jacksondean17/TouchFaderBank/Documentation/LED Test Layout.pdf

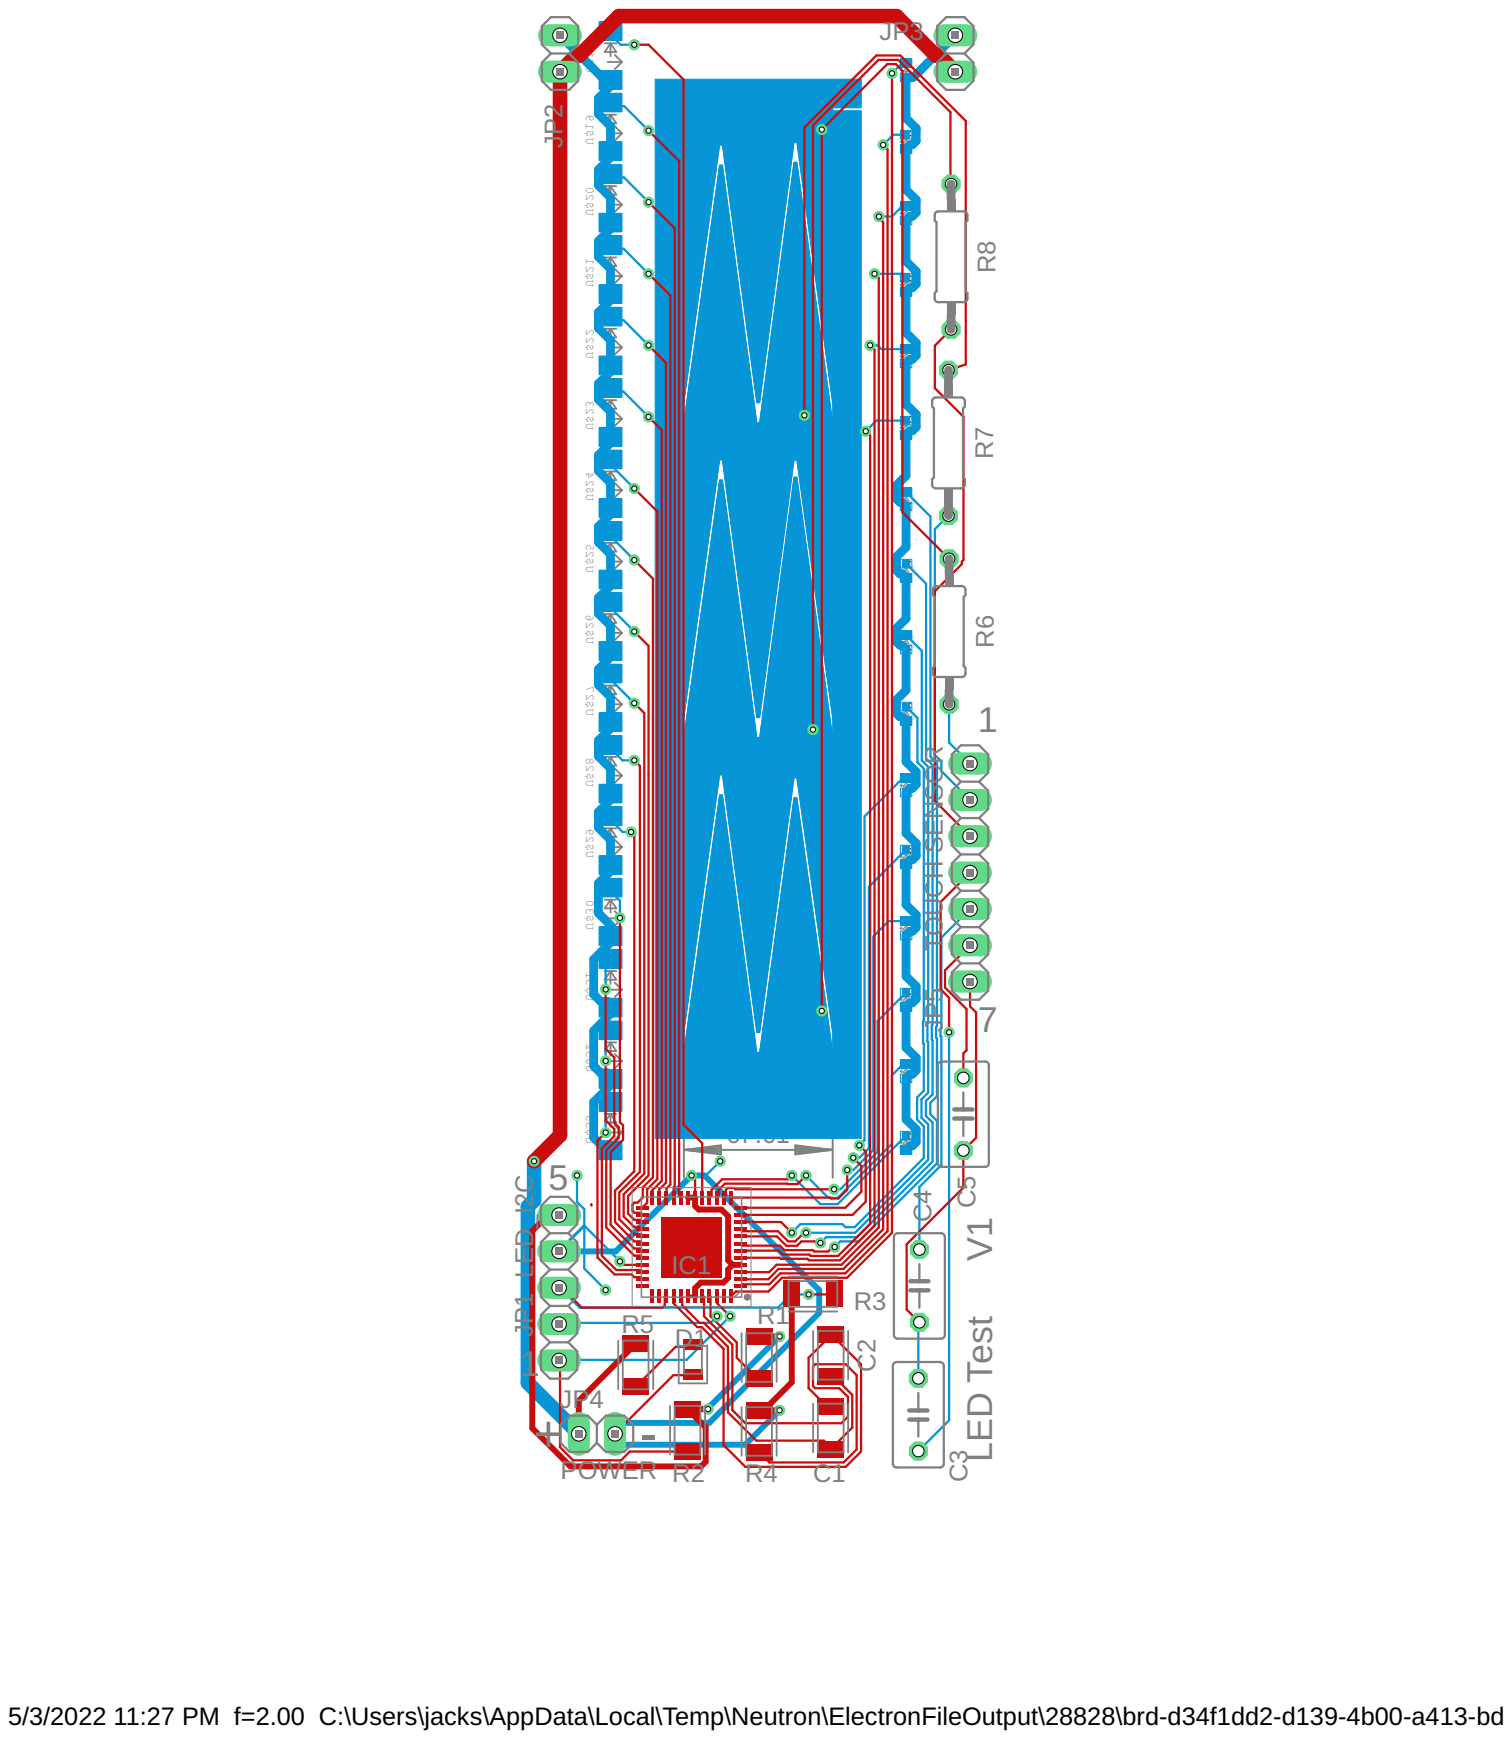
[picture p1: page 1]

5/3/2022 11:27 PM f=2.00 C:\Users\jacks\AppData\Local\Temp\Neutron\ElectronFileOutput\28828\brd-d34f1dd2-d139-4b00-a413-bda9a6092a5e\LED Test v11.brd
