jacksondean17/TouchFaderBank/Documentation/LED Test Schematic.pdf

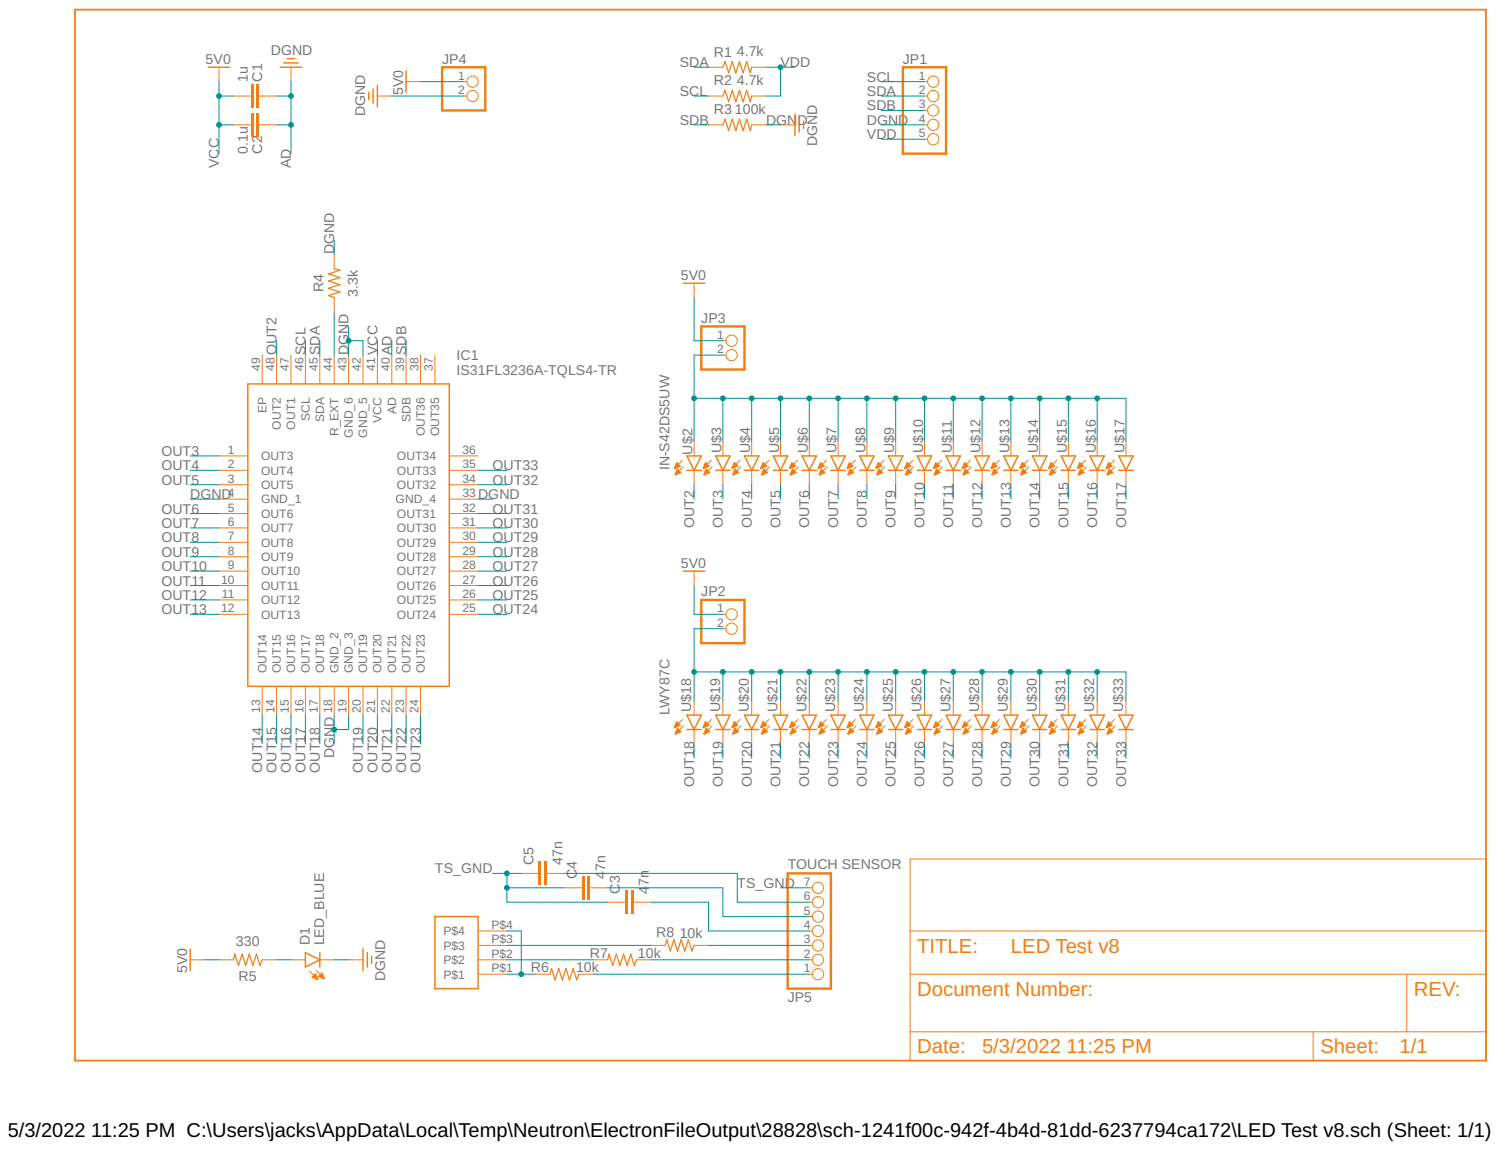
[picture p2: page 1]

Document Number: | REV:

Date: 5/3/2022 11:25 PM | Sheet: 1/1

5/3/2022 11:25 PM C:\Users\jacks\AppData\Local\Temp\Neutron\ElectronFileOutput\28828\sch-1241f00c-942f-4b4d-81dd-6237794ca172\LED Test v8.sch (Sheet: 1/1)
