jacksondean17/TouchFaderBank/Documentation/TouchFaderBank Schematic.pdf

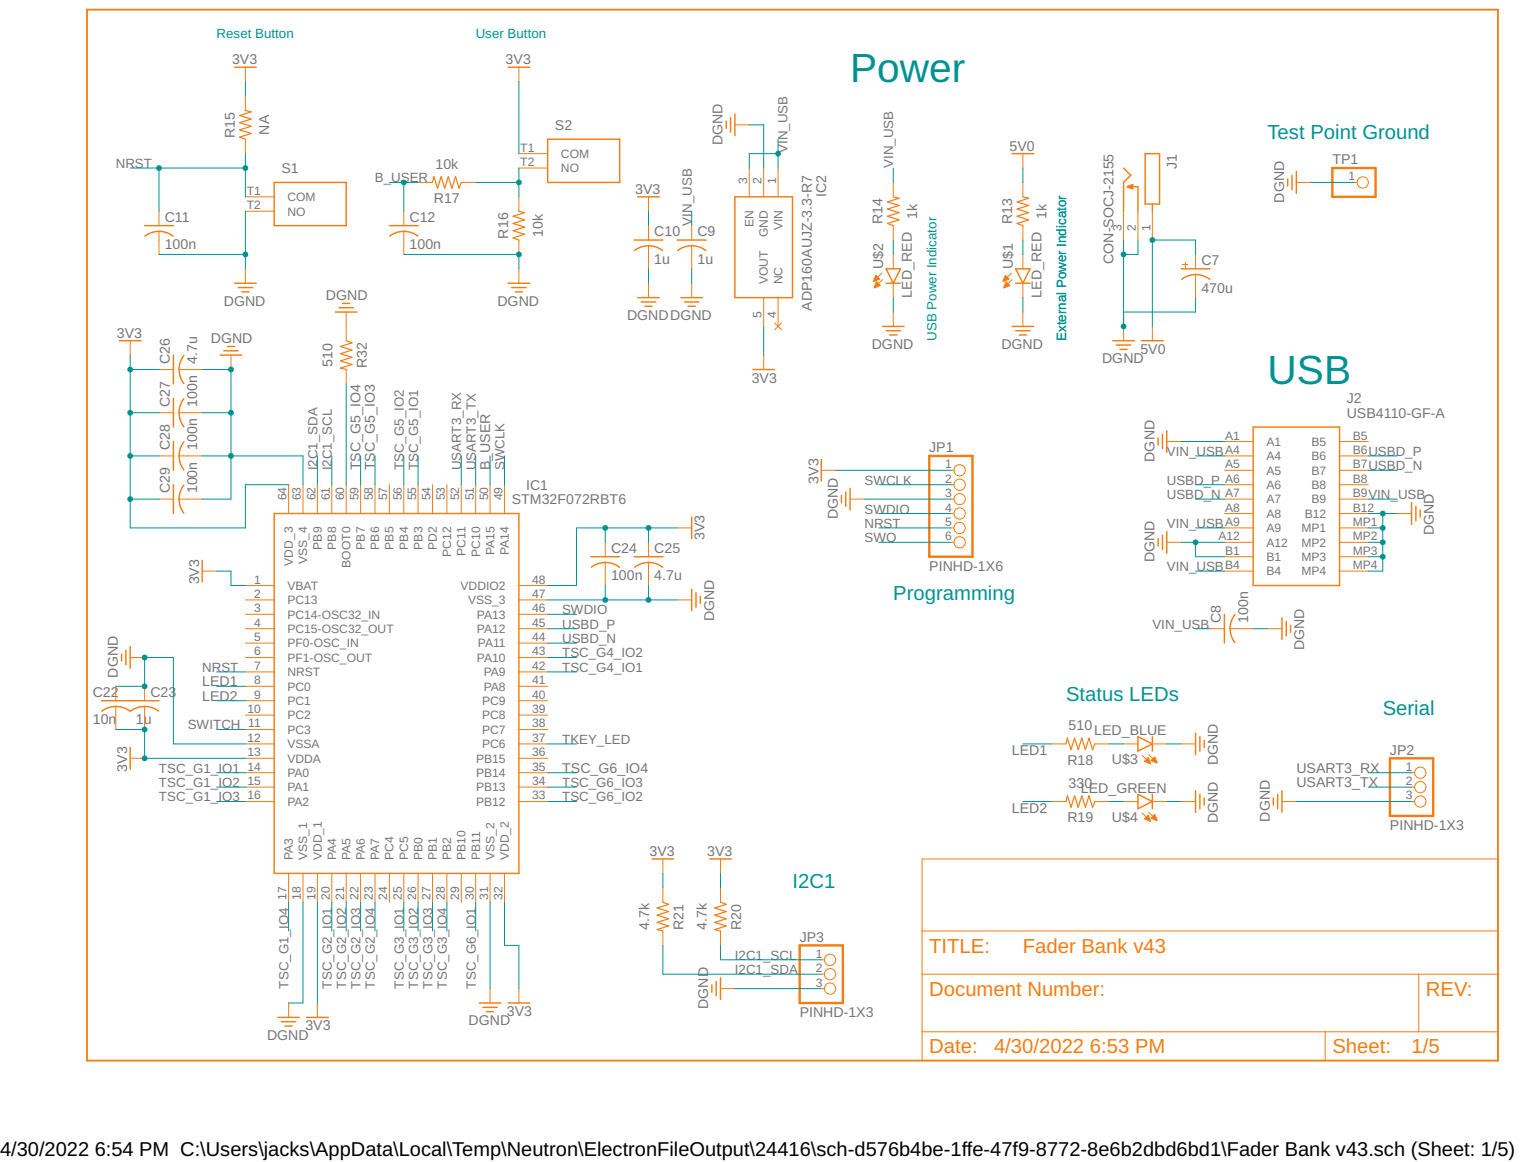
[picture p3: page 1]

External Power Indicator

Document Number: | REV:

Date: 4/30/2022 6:53 PM | Sheet: 1/5

4/30/2022 6:54 PM C:\Users\jacks\AppData\Local\Temp\Neutron\ElectronFileOutput\24416\sch-d576b4be-1ffe-47f9-8772-8e6b2dbd6bd1\Fader Bank v43.sch (Sheet: 1/5)

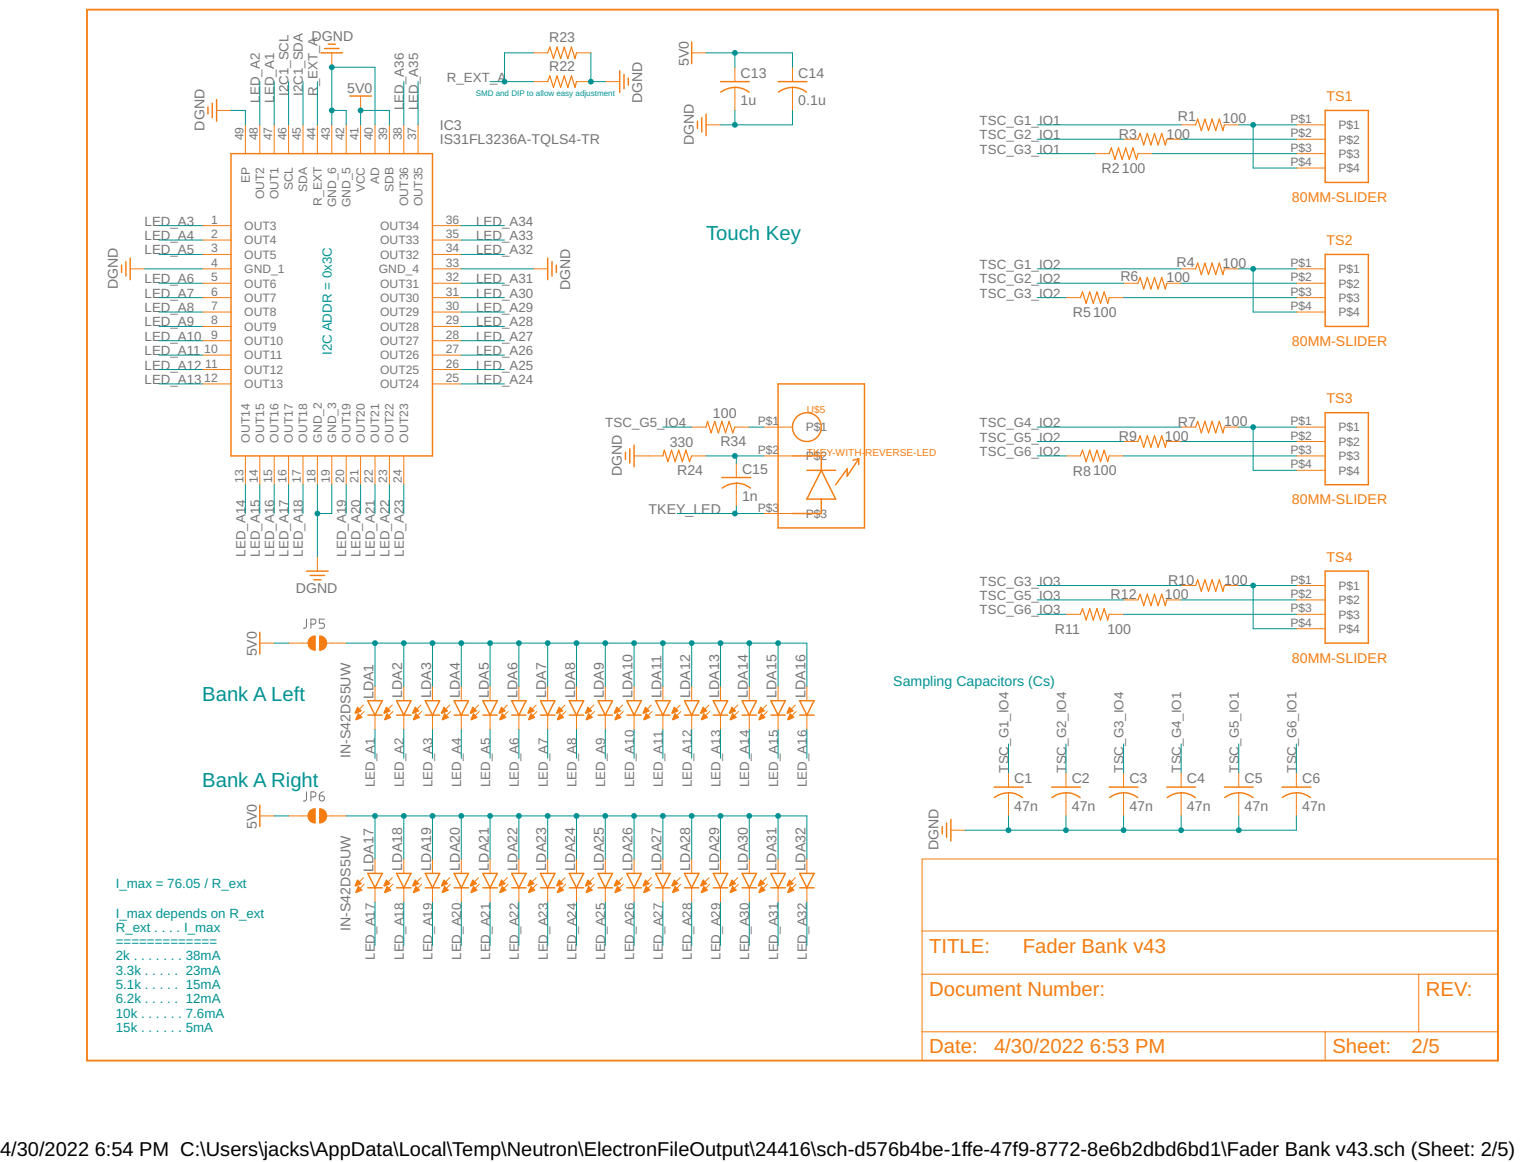
[picture p4: page 2]

SMD and DIP to allow easy adjustment

U$5 TKEY-WITH-REVERSE-LED

Document Number: | REV:

Date: 4/30/2022 6:53 PM | Sheet: 2/5

4/30/2022 6:54 PM C:\Users\jacks\AppData\Local\Temp\Neutron\ElectronFileOutput\24416\sch-d576b4be-1ffe-47f9-8772-8e6b2dbd6bd1\Fader Bank v43.sch (Sheet: 2/5)

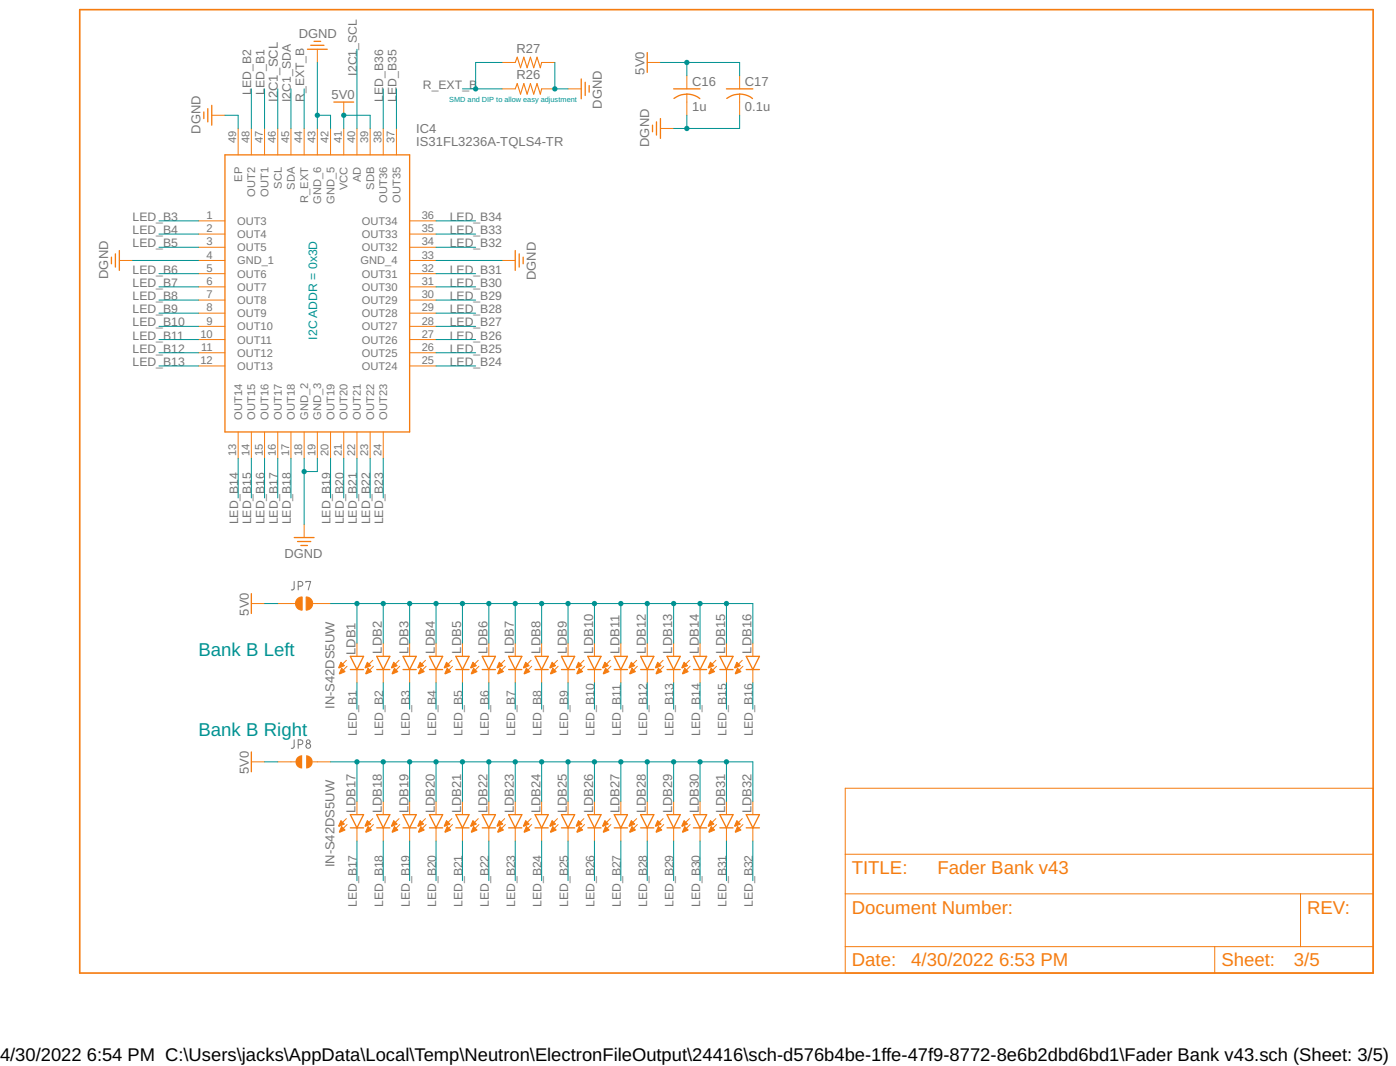
[picture p5: page 3]

SMD and DIP to allow easy adjustment

Document Number: | REV:

Date: 4/30/2022 6:53 PM | Sheet: 3/5

4/30/2022 6:54 PM C:\Users\jacks\AppData\Local\Temp\Neutron\ElectronFileOutput\24416\sch-d576b4be-1ffe-47f9-8772-8e6b2dbd6bd1\Fader Bank v43.sch (Sheet: 3/5)

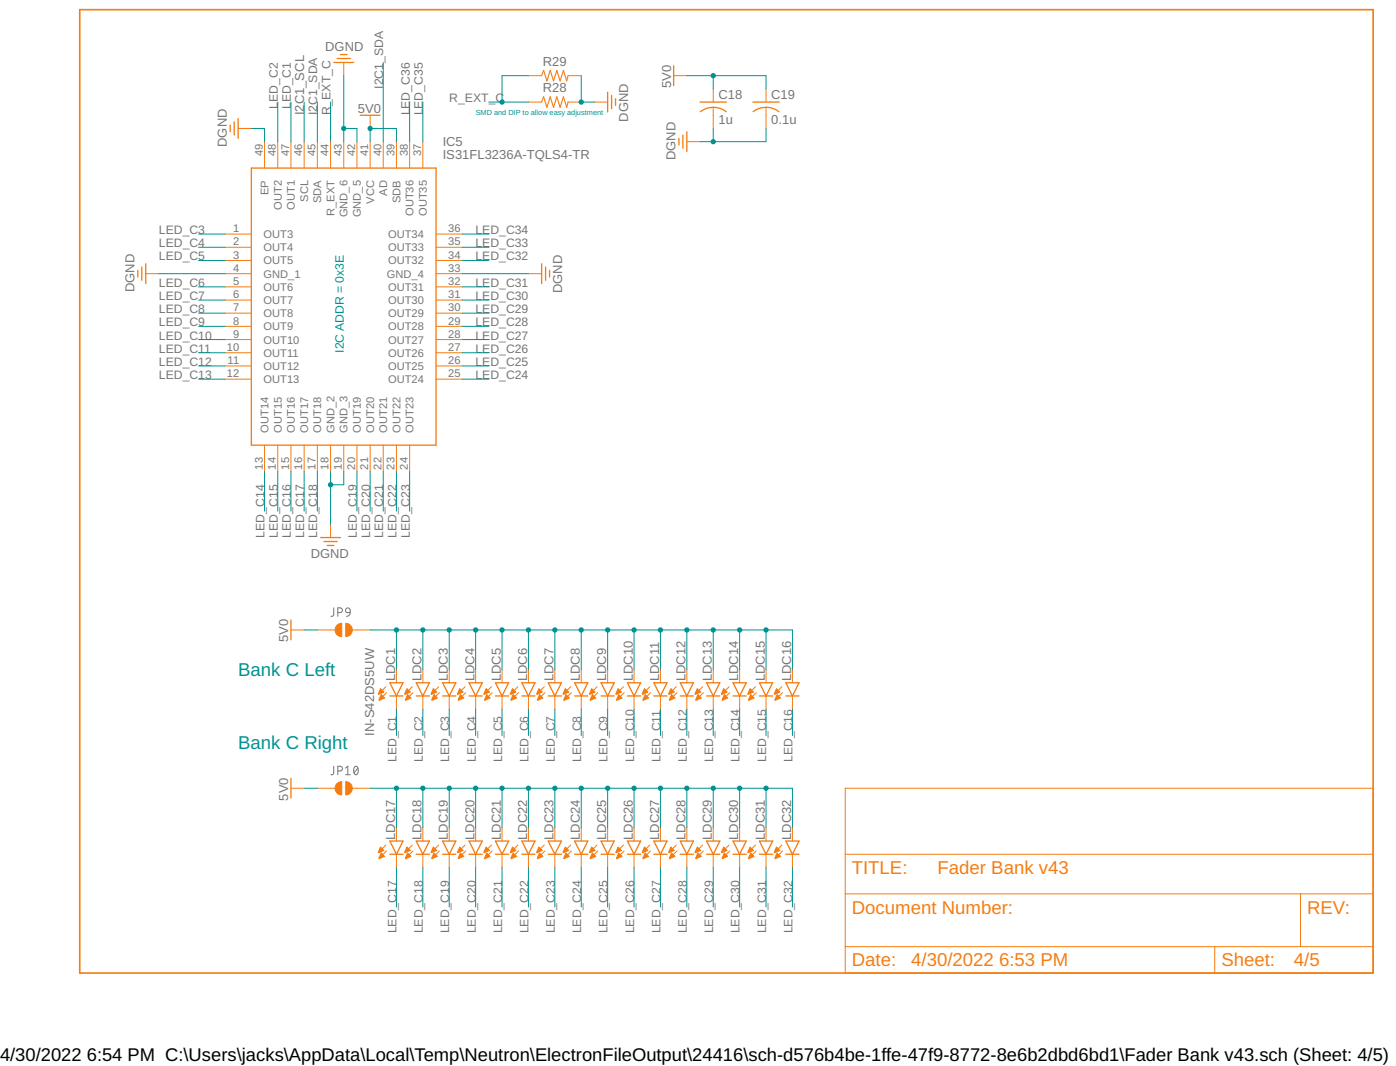
[picture p6: page 4]

SMD and DIP to allow easy adjustment

Document Number: | REV:

Date: 4/30/2022 6:53 PM | Sheet: 4/5

4/30/2022 6:54 PM C:\Users\jacks\AppData\Local\Temp\Neutron\ElectronFileOutput\24416\sch-d576b4be-1ffe-47f9-8772-8e6b2dbd6bd1\Fader Bank v43.sch (Sheet: 4/5)

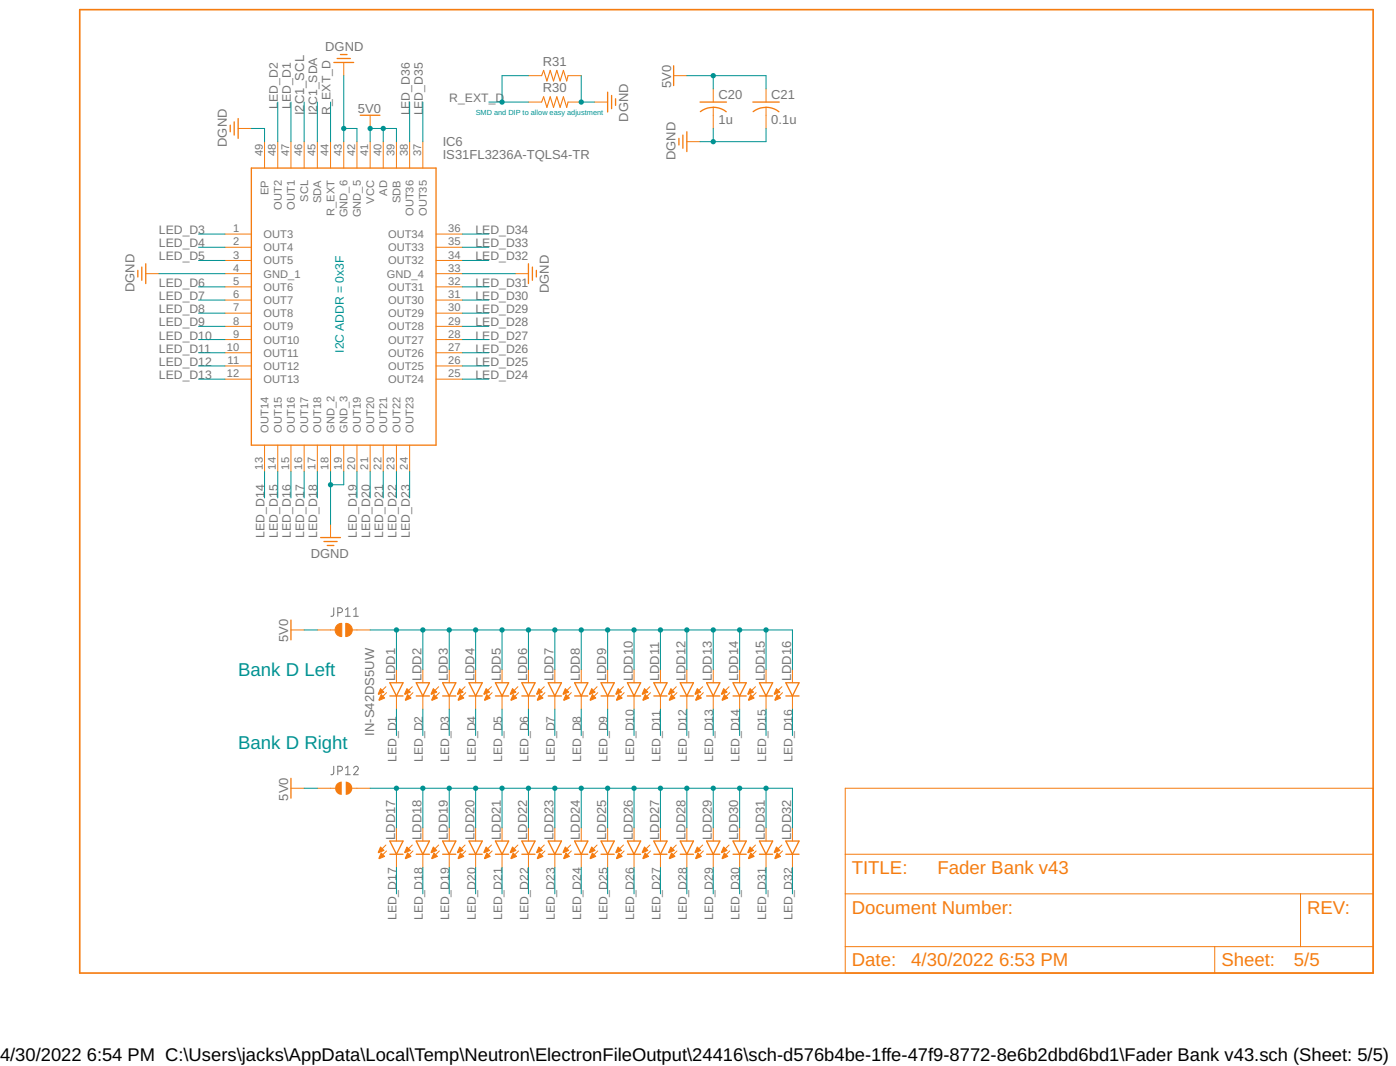
[picture p7: page 5]

SMD and DIP to allow easy adjustment

Document Number: | REV:

Date: 4/30/2022 6:53 PM | Sheet: 5/5

4/30/2022 6:54 PM C:\Users\jacks\AppData\Local\Temp\Neutron\ElectronFileOutput\24416\sch-d576b4be-1ffe-47f9-8772-8e6b2dbd6bd1\Fader Bank v43.sch (Sheet: 5/5)
