jacksondean17/TouchFaderBank/Documentation/TouchFaderBank Layout.pdf

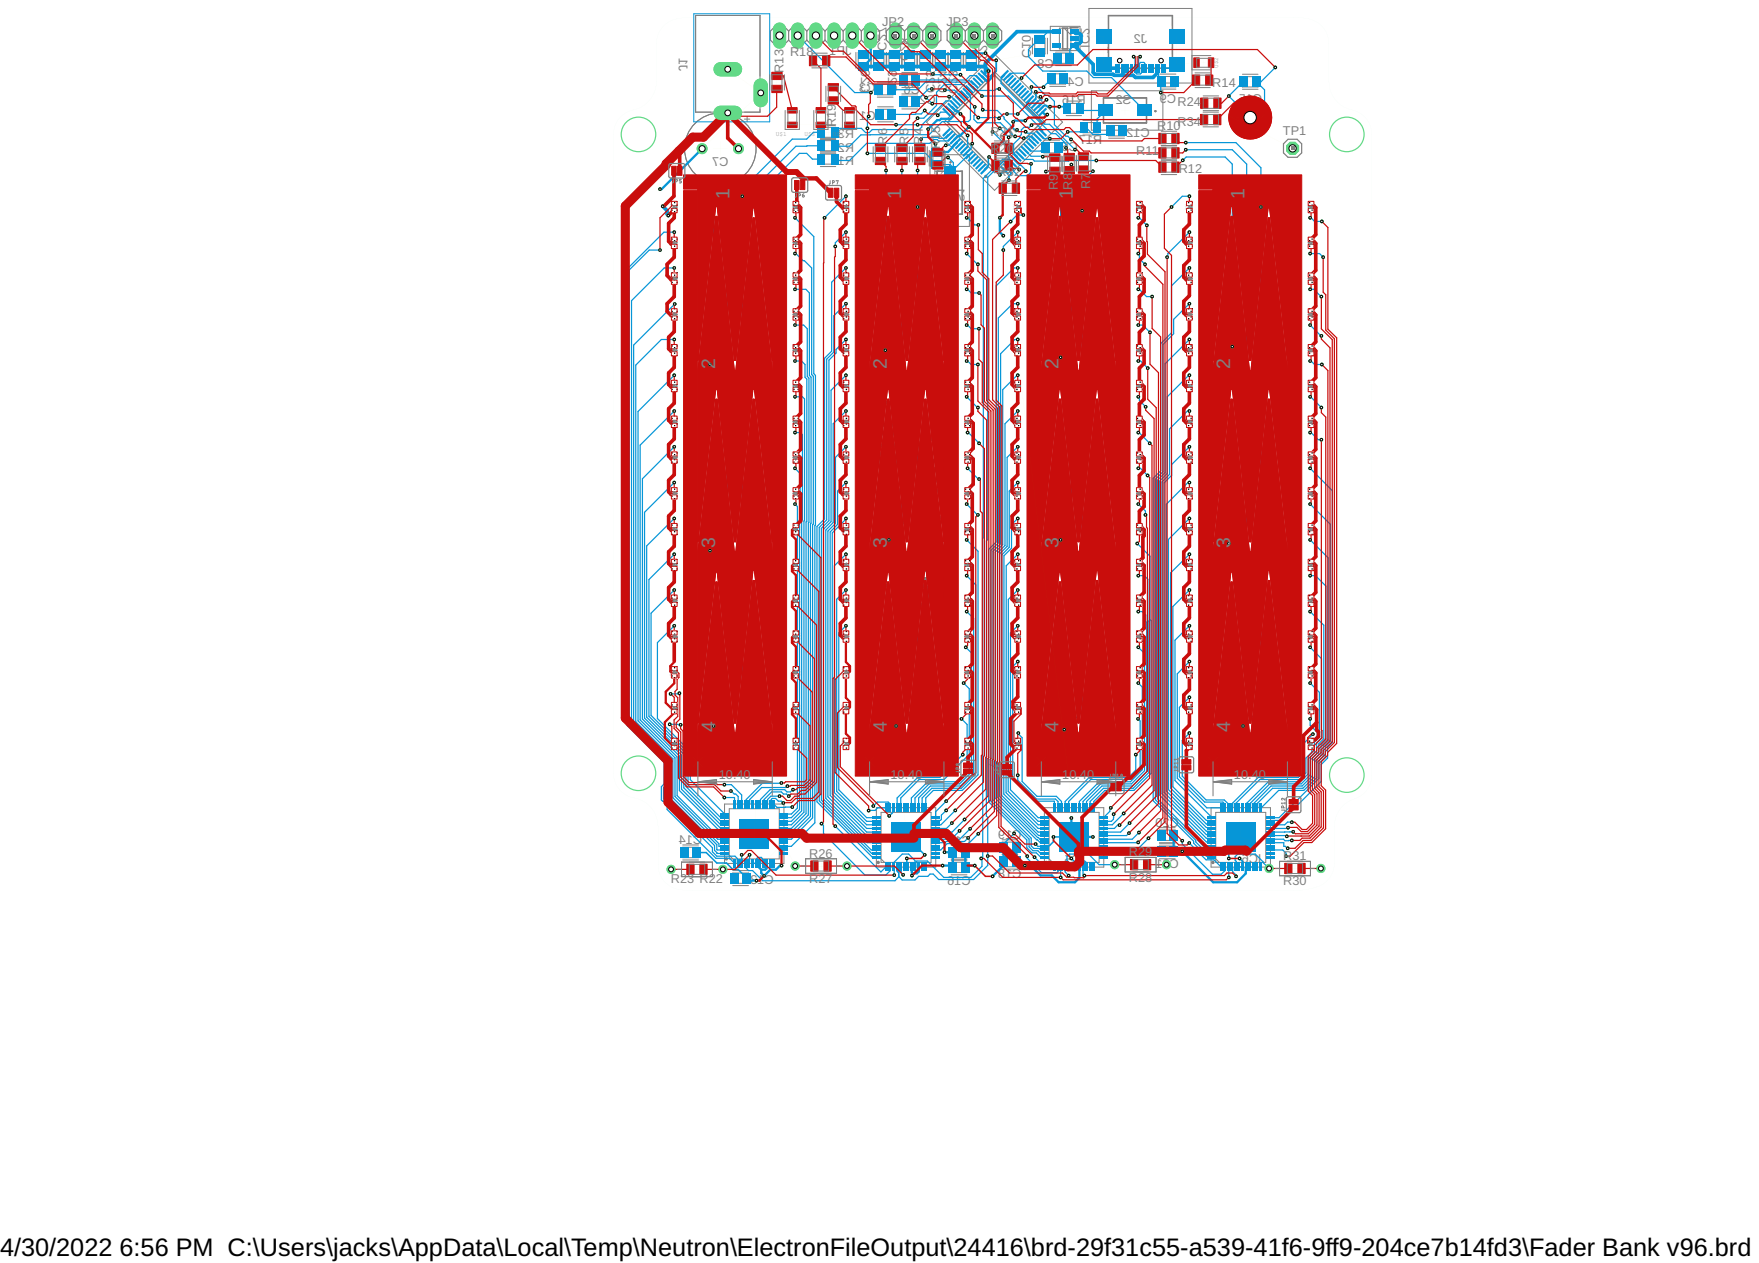
[picture p8: page 1]

4/30/2022 6:56 PM C:\Users\jacks\AppData\Local\Temp\Neutron\ElectronFileOutput\24416\brd-29f31c55-a539-41f6-9ff9-204ce7b14fd3\Fader Bank v96.brd
