jacksondean17/TouchFaderBank/Verification/SliderAndButtons/Core/Src/main.c

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
/* Includes ------------------------------------------------------------------*/
#include "main.h"
#include "touchsensing.h"

/* USER CODE BEGIN Includes */
#include <stdio.h>
/* USER CODE END Includes */

/* USER CODE BEGIN PD */
#define SBUF_SIZE (128)
/* USER CODE END PD */

/* USER CODE BEGIN PM */
#define LINEAR_DETECT(chan) ((MyLinRots[chan].p_Data->StateId == TSL_STATEID_DETECT) || \
                       (MyLinRots[chan].p_Data->StateId == TSL_STATEID_DEB_RELEASE_DETECT))
#define LINEAR_POSITION(chan) (MyLinRots[chan].p_Data->Position)

#define KEY_DETECT(chan) ((MyTKeys[chan].p_Data->StateId == TSL_STATEID_DETECT) || \
                       (MyTKeys[chan].p_Data->StateId == TSL_STATEID_DEB_RELEASE_DETECT))

/* USER CODE END PM */

 TSC_HandleTypeDef htsc;

UART_HandleTypeDef huart1;

/* USER CODE BEGIN PV */
char sbuf[SBUF_SIZE];
uint8_t pos;
int size;
/* USER CODE END PV */

void SystemClock_Config(void);
static void MX_GPIO_Init(void);
static void MX_TSC_Init(void);
static void MX_USART1_UART_Init(void);
/**
  * @brief  The application entry point.
  * @retval int
  */
int main(void)
{
  /* USER CODE BEGIN 1 */
  tsl_user_status_t tsl_status;

  /* USER CODE END 1 */

  /* MCU Configuration--------------------------------------------------------*/

  /* Reset of all peripherals, Initializes the Flash interface and the Systick. */
  HAL_Init();

  /* Configure the system clock */
  SystemClock_Config();

  /* Initialize all configured peripherals */
  MX_GPIO_Init();
  MX_TSC_Init();
  MX_USART1_UART_Init();
  MX_TOUCHSENSING_Init();
  /* Infinite loop */
  /* USER CODE BEGIN WHILE */
  while (1)
  {		
		tsl_status = tsl_user_Exec();
		if (tsl_status != TSL_USER_STATUS_BUSY)
		{
			
			if (LINEAR_DETECT(0))
			{
				HAL_GPIO_WritePin(GPIOC, LD4_Pin, GPIO_PIN_SET);

				pos = LINEAR_POSITION(0);
				
				size = sprintf(sbuf, "slider 0: %d\r\n", pos);
				HAL_UART_Transmit(&huart1, (uint8_t *)sbuf, size, 5000);
				
			} else {
				HAL_GPIO_WritePin(GPIOC, LD4_Pin, GPIO_PIN_RESET);
			}
			
			if (LINEAR_DETECT(1)) {
				HAL_GPIO_WritePin(GPIOC, LD5_Pin, GPIO_PIN_SET);

				pos = LINEAR_POSITION(1);
				
				size = sprintf(sbuf, "slider 1: %d\r\n", pos);
				HAL_UART_Transmit(&huart1, (uint8_t *)sbuf, size, 5000);
				size = sprintf(sbuf, "\tdelta 1: %d\r\n", MyLinRots[1].p_ChD[0].Delta);
				HAL_UART_Transmit(&huart1, (uint8_t *)sbuf, size, 5000);
				size = sprintf(sbuf, "\tdelta 2: %d\r\n", MyLinRots[1].p_ChD[1].Delta);
				HAL_UART_Transmit(&huart1, (uint8_t *)sbuf, size, 5000);
				size = sprintf(sbuf, "\tdelta 3: %d\r\n", MyLinRots[1].p_ChD[2].Delta);
				HAL_UART_Transmit(&huart1, (uint8_t *)sbuf, size, 5000);
				
				
			} else {
				HAL_GPIO_WritePin(GPIOC, LD5_Pin, GPIO_PIN_RESET);
			}				
			
			// 3 touch keys
//			if (KEY_DETECT(0))
//			{
//				size = sprintf(sbuf, "key0: %d\r\n", MyTKeys[0].p_ChD->Delta);
//				HAL_UART_Transmit(&huart1, (uint8_t *)sbuf, size, 5000);
//				HAL_GPIO_WritePin(GPIOC, LD5_Pin, GPIO_PIN_SET);
//			} else {
//				HAL_GPIO_WritePin(GPIOC, LD5_Pin, GPIO_PIN_RESET);
//			}
//			if (KEY_DETECT(1))
//			{
//				size = sprintf(sbuf, "key1: %d\r\n", MyTKeys[1].p_ChD->Delta);
//				HAL_UART_Transmit(&huart1, (uint8_t *)sbuf, size, 5000);
//				HAL_GPIO_WritePin(GPIOC, LD3_Pin, GPIO_PIN_SET);
//			} else {
//				HAL_GPIO_WritePin(GPIOC, LD3_Pin, GPIO_PIN_RESET);
//			}
//			if (KEY_DETECT(2))
//			{
//				size = sprintf(sbuf, "key2: %d\r\n", MyTKeys[2].p_ChD->Delta);
//				HAL_UART_Transmit(&huart1, (uint8_t *)sbuf, size, 5000);
//				HAL_GPIO_WritePin(GPIOC, LD6_Pin, GPIO_PIN_SET);
//			} else {
//				HAL_GPIO_WritePin(GPIOC, LD6_Pin, GPIO_PIN_RESET);
//			}
		}
				
    /* USER CODE END WHILE */

    /* USER CODE BEGIN 3 */
  }
  /* USER CODE END 3 */
}

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
