jacksondean17/TouchFaderBank/Verification/SliderAndButtons/Core/Inc/main.h

#define NCS_MEMS_SPI_Pin GPIO_PIN_0
#define NCS_MEMS_SPI_GPIO_Port GPIOC
#define MEMS_INT1_Pin GPIO_PIN_1
#define MEMS_INT1_GPIO_Port GPIOC
#define MEMS_INT2_Pin GPIO_PIN_2
#define MEMS_INT2_GPIO_Port GPIOC
#define B1_Pin GPIO_PIN_0
#define B1_GPIO_Port GPIOA
#define EXT_RESET_Pin GPIO_PIN_5
#define EXT_RESET_GPIO_Port GPIOC
#define LD3_Pin GPIO_PIN_6
#define LD3_GPIO_Port GPIOC
#define LD6_Pin GPIO_PIN_7
#define LD6_GPIO_Port GPIOC
#define LD4_Pin GPIO_PIN_8
#define LD4_GPIO_Port GPIOC
#define LD5_Pin GPIO_PIN_9
#define LD5_GPIO_Port GPIOC
#define SWDIO_Pin GPIO_PIN_13
#define SWDIO_GPIO_Port GPIOA
#define SWCLK_Pin GPIO_PIN_14
#define SWCLK_GPIO_Port GPIOA
