jacksondean17/TouchFaderBank/(commit log)

2022-04-01 init. Single button works
2022-04-01 External slider used as buttons working
    modified threshold coefficient
2022-05-01 Added STMCube project for final PCB and removed earlier project
2022-05-01 Generate MDK-ARM project and test programming
    Used STM32CubeMX to generate an MDK-ARM project for the fully assembled fader bank PCB. Tested programming of the MCU by flashing a program to turn on the status LEDs plus the touch button LED. Worked on the first try!
2022-05-02 Fixed Touch Key channel
    [tsl_conf.h, tsl_user.h]
2022-05-02 Add LED Driver Test project
2022-05-02 initial LED test works!!!
2022-05-03 LEDs and MIDI all works!
2022-05-03 Moved LED logic to separate files
2022-05-03 Reversed positive direction and fixed init
    [IS31FL3236A_led_driver.c, fader_bank.c, tsl_user.h]
2022-05-03 LEDs broke? Added relative movement
    [IS31FL3236A_led_driver.c, IS31FL3236A_led_driver.h, fader_bank.c, fader_bank.h, main.c]
2022-05-04 Bug fixes
    Fixed initialization bug, dimming bug
    [IS31FL3236A_led_driver.c, IS31FL3236A_led_driver.h, fader_bank.c, fader_bank.h, main.c, tsl_conf.h]
2022-05-05 Expand .gitignore and add Verification folder
    The Verification folder is used to consolidate the test projects LED Driver Test and SliderAndButtons.
