jacksondean17/TouchFaderBank/(notices)

Notices in the files:
Verification/SliderAndButtons/Core/Inc/main.h:
Copyright (c) 2022 STMicroelectronics.
All rights reserved.
